simoncrabbuk/morse-keyer/stl/Enclosure with Lid.stl

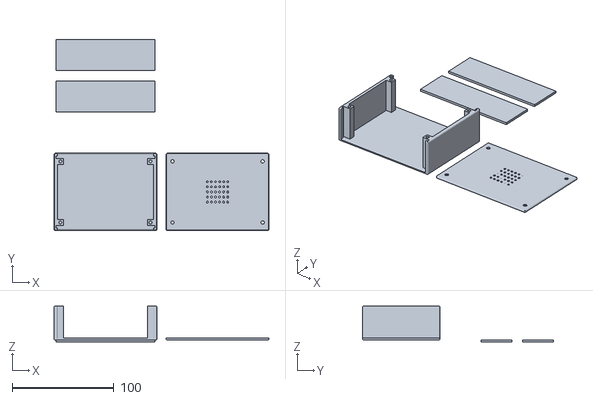
[picture p3: CAD file, 2026-10-24]
stl/Enclosure with Lid.stl
211.0 x 187.8 x 35.0
