simoncrabbuk/morse-keyer/stl/Back Panel.step

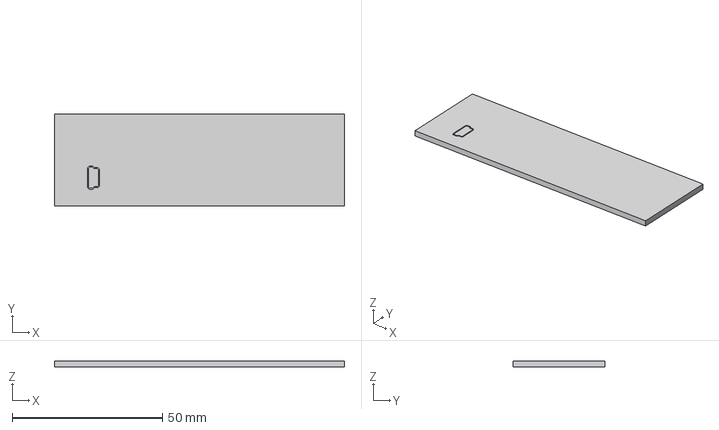
[picture p4: CAD file, 2026-10-24]
stl/Back Panel.step
96.5 x 30.8 x 2.00 mm
