simoncrabbuk/morse-keyer/stl/Blank Panel.stl

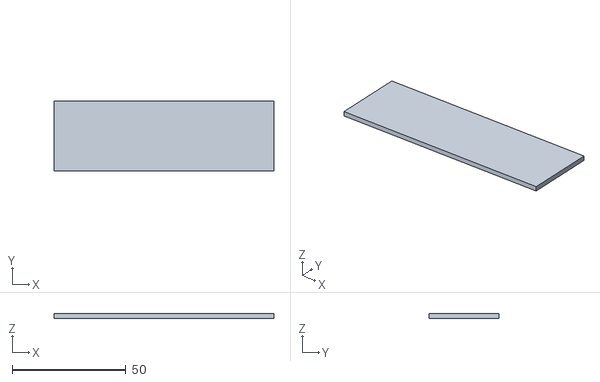
[picture p5: CAD file, 2026-10-24]
stl/Blank Panel.stl
96.5 x 30.8 x 2.00
