simoncrabbuk/morse-keyer/stl/Front Panel.step

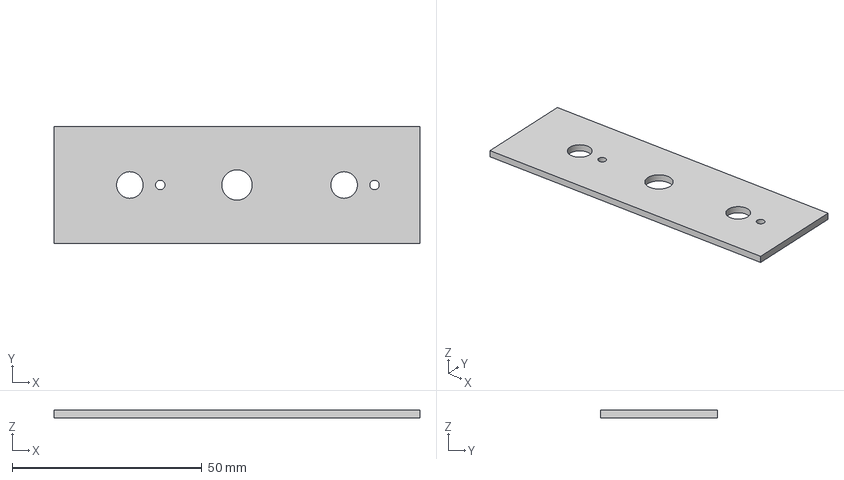
[picture p6: CAD file, 2026-10-24]
stl/Front Panel.step
96.5 x 30.8 x 2.00 mm
