simoncrabbuk/morse-keyer/(commit log)

2026-10-24 Add README, 3D printable STL and STEP models, and clean gitignore
    [Back Panel.step, Blank Panel.stl, Enclosure with Lid.stl, Front Panel.step]
2026-10-24 Update README title, add build photos, and add note on prototype construction
